OffGrid-Devices/Falange/README.md

# OffGrid-Devices Falange
Arduino-based delay weirdo

[BOM](https://docs.google.com/spreadsheets/d/1_OFgzQ-Cf3UgnrHv29c7YLzdb8jIv9dC1f2YYJAlo-E/edit?usp=sharing)
