OffGrid-Devices/Falange/schematics/Falange-NANO/PDF/FalangeNANO_Board_BOTTOM (mirrored).pdf

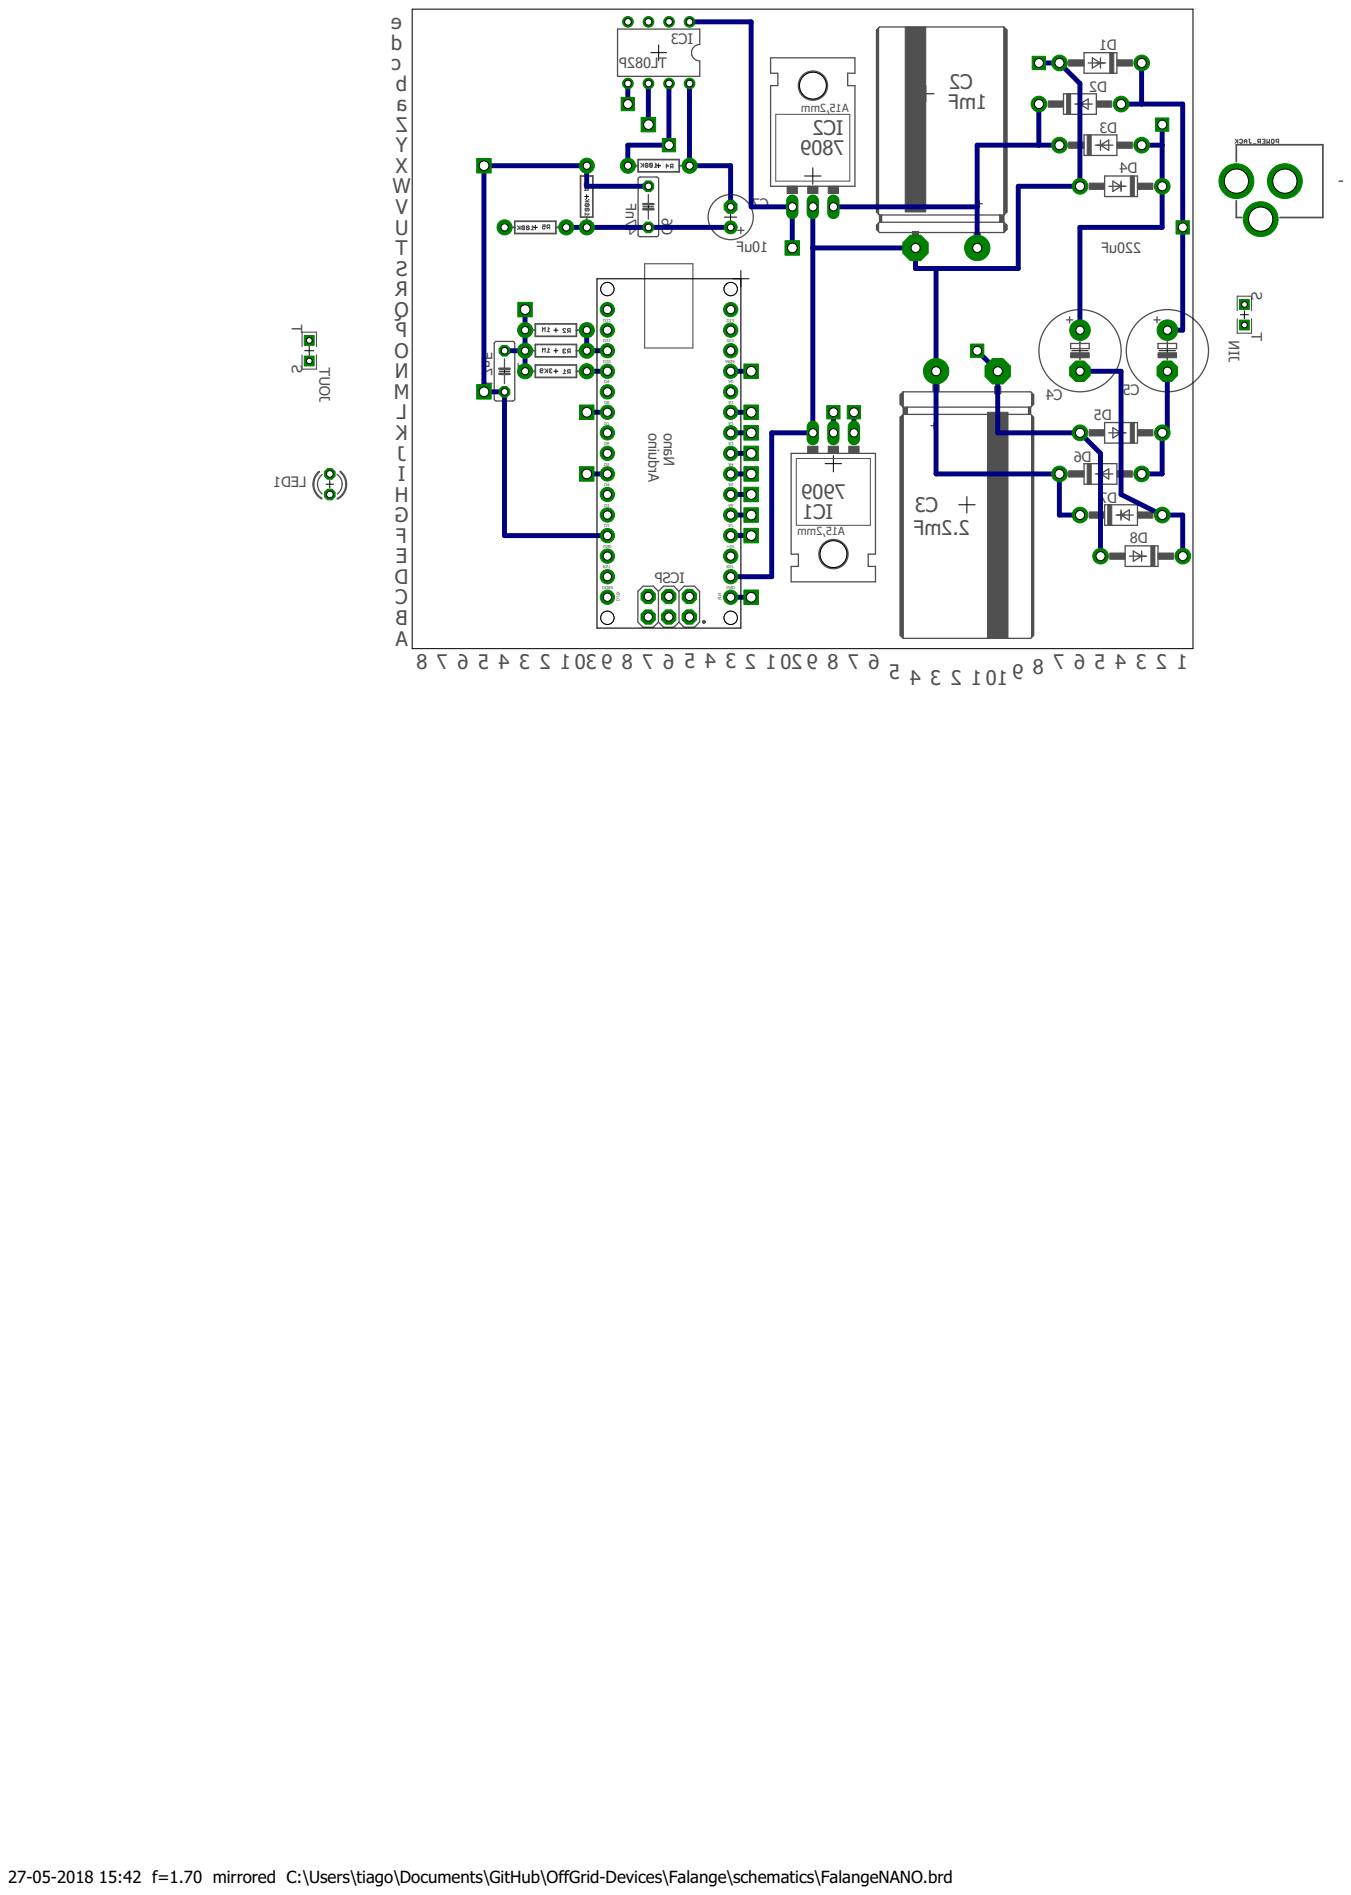
[picture p1: page 1]

27-05-2018 15:42 f=1.70 mirrored C:\Users\tiago\Documents\GitHub\OffGrid-Devices\Falange\schematics\FalangeNANO.brd

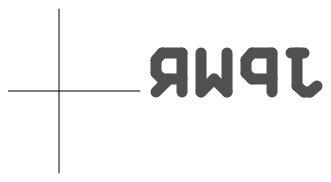
[picture p2: page 2]
