OffGrid-Devices/Falange/schematics/Falange-NANO/PDF/FalangeNANO_Components_TOP.pdf

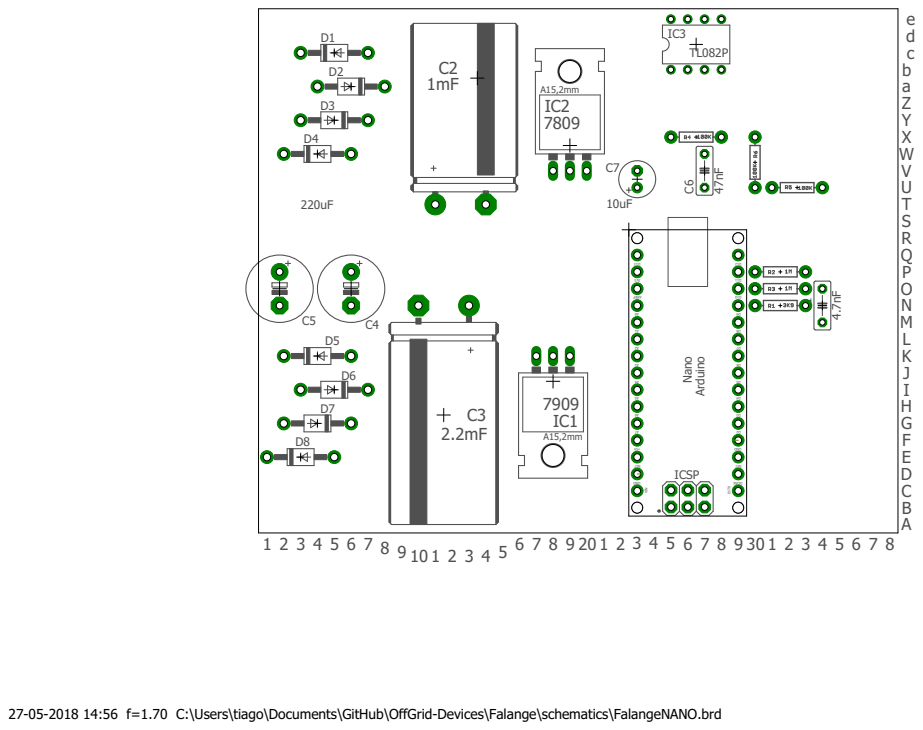
[picture p3: page 1]

27-05-2018 14:56 f=1.70 C:\Users\tiago\Documents\GitHub\OffGrid-Devices\Falange\schematics\FalangeNANO.brd
