OffGrid-Devices/Falange/schematics/Falange-NANO/PDF/FalangeNANO_OnBoard_Connections_5V_TOP.pdf

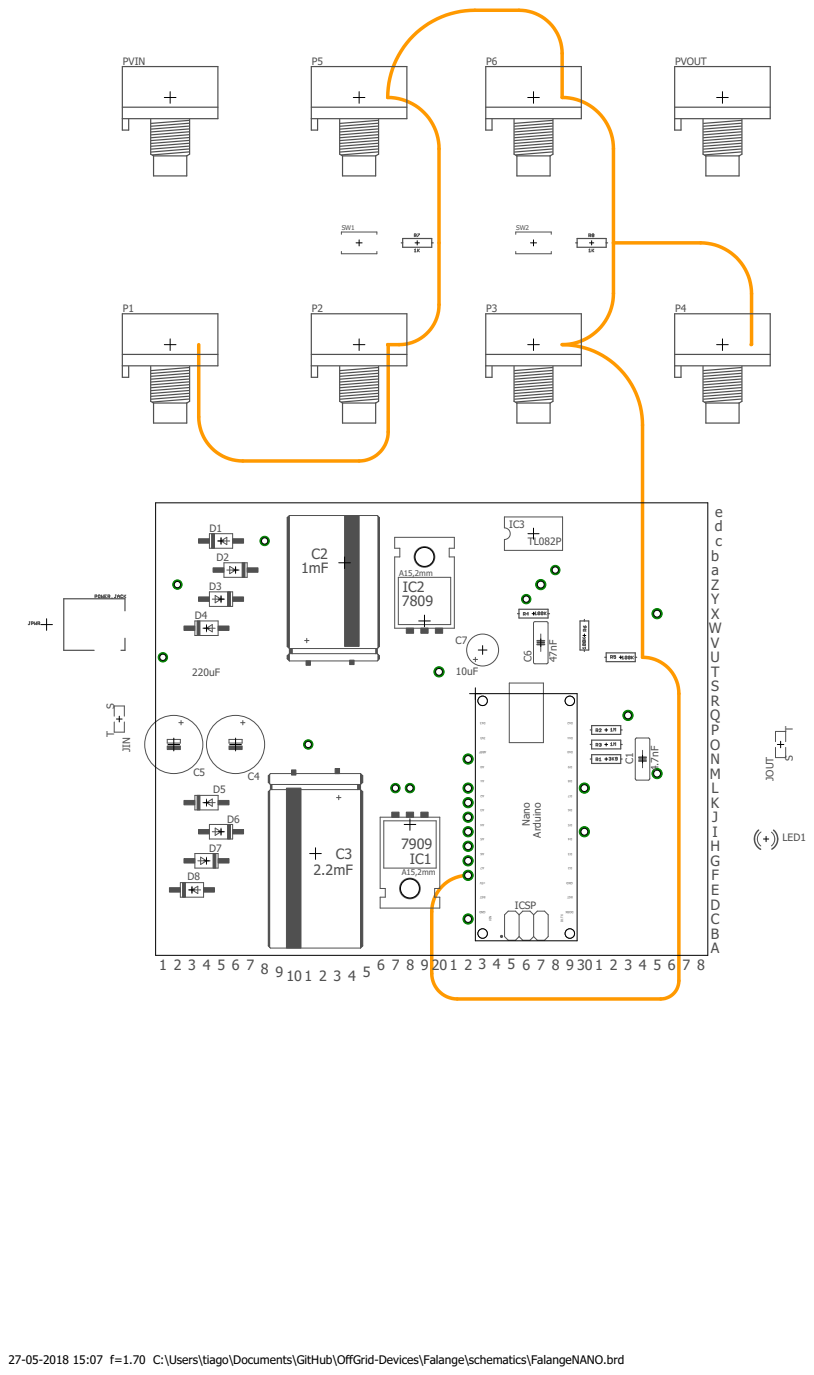
[picture p4: page 1]

27-05-2018 15:07 f=1.70 C:\Users\tiago\Documents\GitHub\OffGrid-Devices\Falange\schematics\FalangeNANO.brd
