OffGrid-Devices/Falange/schematics/Falange-NANO/PDF/FalangeNANO_OnBoard_Connections_9V_TOP.pdf

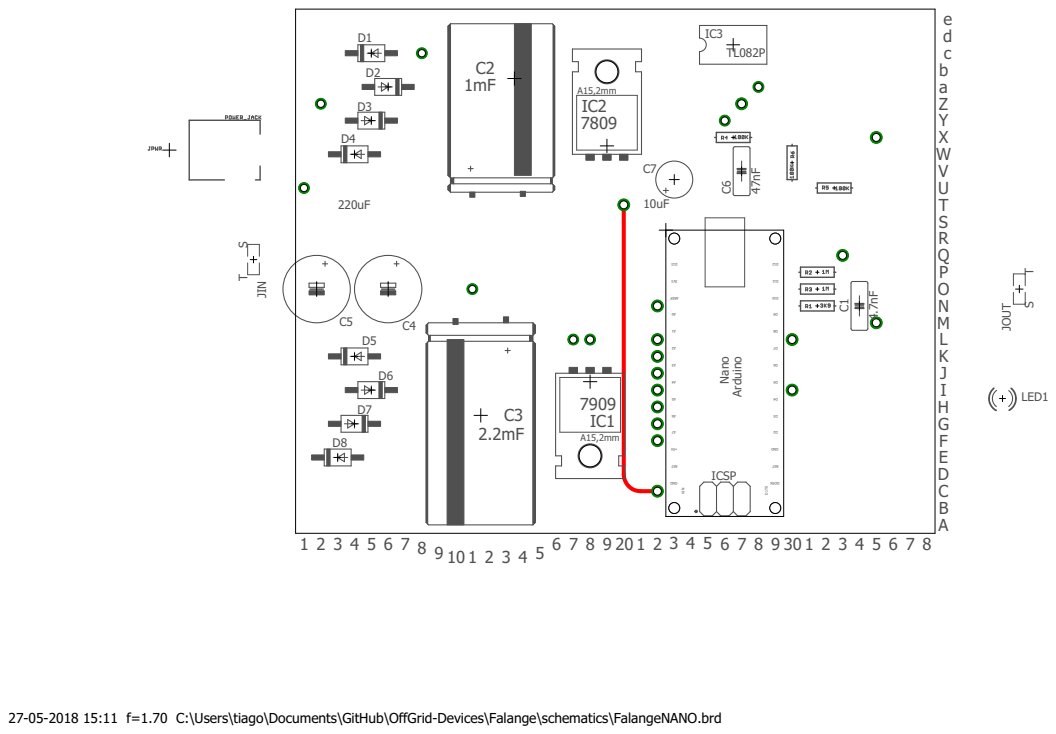
[picture p5: page 1]

27-05-2018 15:11 f=1.70 C:\Users\tiago\Documents\GitHub\OffGrid-Devices\Falange\schematics\FalangeNANO.brd
