OffGrid-Devices/Falange/schematics/Falange-NANO/PDF/FalangeNANO_OnBoard_Connections_GROUND_TOP.pdf

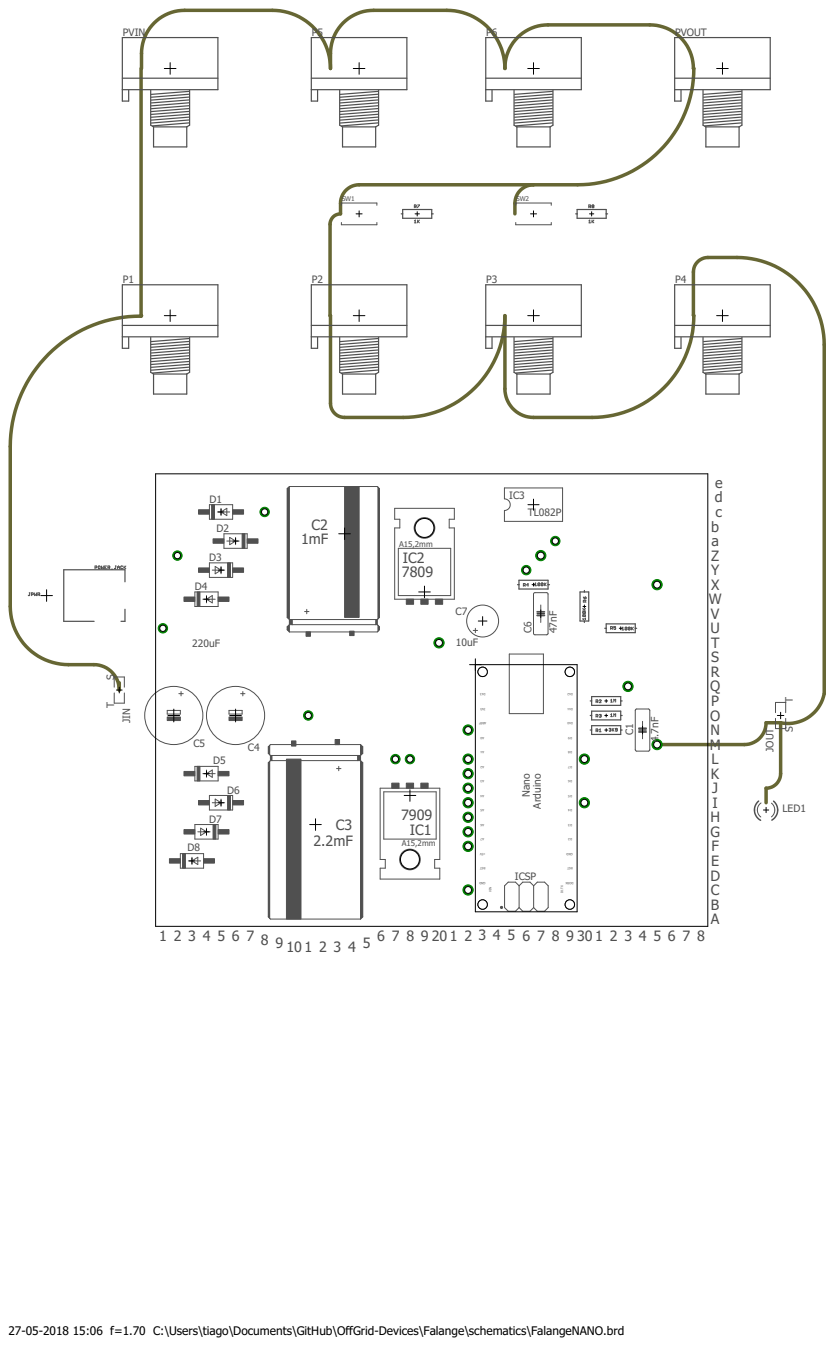
[picture p8: page 1]

27-05-2018 15:06 f=1.70 C:\Users\tiago\Documents\GitHub\OffGrid-Devices\Falange\schematics\FalangeNANO.brd
