OffGrid-Devices/Falange/schematics/FalangeNANO.brd

## EAGLE design schematics/FalangeNANO.brd (2019-09-03)

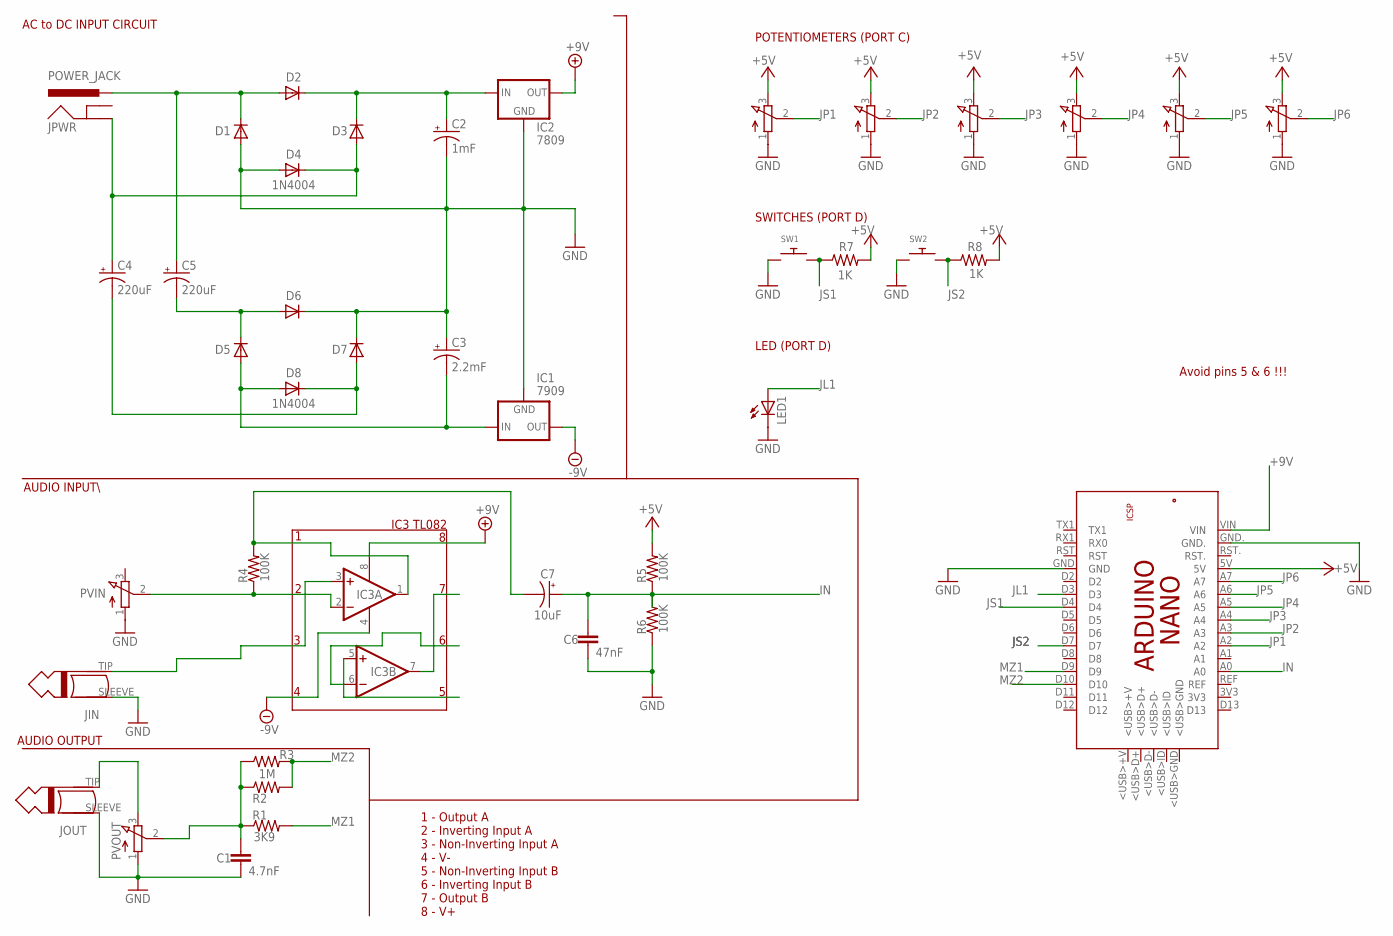
[picture p10: schematic FalangeNANO.sch]

Parts:
C1: 4.7nF; C050-025X075
C2: 1mF; E30-16
C3: 2.2mF; E35-16
C4, C5: 220uF; E5-10,5
C6: 47nF; C050-025X075
C7: 10uF; E2,5-6
D1, D2, D3, D4, D5, D6, D7, D8: 1N4004; DO41-10
IC1: 7909; 79XXL
IC2: 7809; 78XXL
IC3: TL082P; DIL08
JIN: MONO_PLUG; TWO_PADS
JOUT: MONO_PLUG; TWO_PADS
JPWR: POWER_JACK; POWER_JACK_PTH
LED1: LED3MM
P1, P2, P3, P4, P5, P6: 3RP/1610N
PCB1: ARDUINO_NANO
PVIN: 3RP/1610N
PVOUT: 3RP/1610N
R1: 3K9; AXIAL-0.3
R2, R3: 1M; AXIAL-0.3
R4, R5, R6: 100K; AXIAL-0.3
R7, R8: 1K; AXIAL-0.3
SW1, SW2: SWITCH_PUSHBUTTONEVQ-PE; TACT_PANA-EVQ

Connections:
+5V: P1.3 (E), P2.3 (E), P3.3 (E), P4.3 (E), P5.3 (E), P6.3 (E), PCB1.5V, R5.P$2 (2), R7.P$2 (2), R8.P$2 (2)
+9V: IC2.OUT, IC3.8 (V+), PCB1.VIN
-9V: IC1.OUT, IC3.4 (V-)
GND: C1.2, C2.-, C3.+, C6.2, D1.A, D4.A, D6.C, D7.C, IC1.GND, IC2.GND, JIN.SLEEVE, JOUT.SLEEVE, LED1.K (C), P1.1 (A), P2.1 (A), P3.1 (A), P4.1 (A), P5.1 (A), P6.1 (A), PCB1.GND, PCB1.GND., PVIN.1 (A), PVOUT.1 (A), R6.P$1 (1), SW1.P$1, SW2.P$1
IN: C6.1, C7.+, PCB1.A0, R5.P$1 (1), R6.P$2 (2)
JL1: LED1.A, PCB1.D3
JP1: P1.2 (S), PCB1.A2
JP2: P2.2 (S), PCB1.A3
JP3: P3.2 (S), PCB1.A4
JP4: P4.2 (S), PCB1.A5
JP5: P5.2 (S), PCB1.A6
JP6: P6.2 (S), PCB1.A7
JP8-2: C1.1, PVOUT.2 (S), R1.P$1 (1), R2.P$1 (1), R3.P$1 (1)
JP8-3: JOUT.TIP, PVOUT.3 (E)
JS1: PCB1.D4, R7.P$1 (1), SW1.P$2
JS2: PCB1.D7, R8.P$1 (1), SW2.P$2
MZ1: PCB1.D9, R1.P$2 (2)
MZ2: PCB1.D10, R2.P$2 (2), R3.P$2 (2)
unnamed: C5.-, D5.C, D6.A
unnamed: C4.-, D7.A, D8.C
unnamed: C2.+, D2.C, D3.C, IC2.IN
unnamed: C3.-, D5.A, D8.A, IC1.IN
unnamed: C7.-, IC3.1 (OUT), R4.P$2 (2)
unnamed: IC3.2 (-IN), PVIN.2 (S), R4.P$1 (1)
unnamed: IC3.3 (+IN), JIN.TIP
PWRSLV: C4.+, D3.A, D4.C, JPWR.GND
PWRTIP: C5.+, D1.C, D2.A, JPWR.PWR

Notes on the sheet:
AUDIO OUTPUT
AC to DC INPUT CIRCUIT
AUDIO INPUT\
IC3 TL082
1 - Output A 2 - Inverting Input A 3 - Non-Inverting Input A 4 - V- 5 - Non-Inverting Input B 6 - Inverting Input B 7 - Output B 8 - V+
POTENTIOMETERS (PORT C)
SWITCHES (PORT D)
LED (PORT D)
Avoid pins 5 & 6 !!!

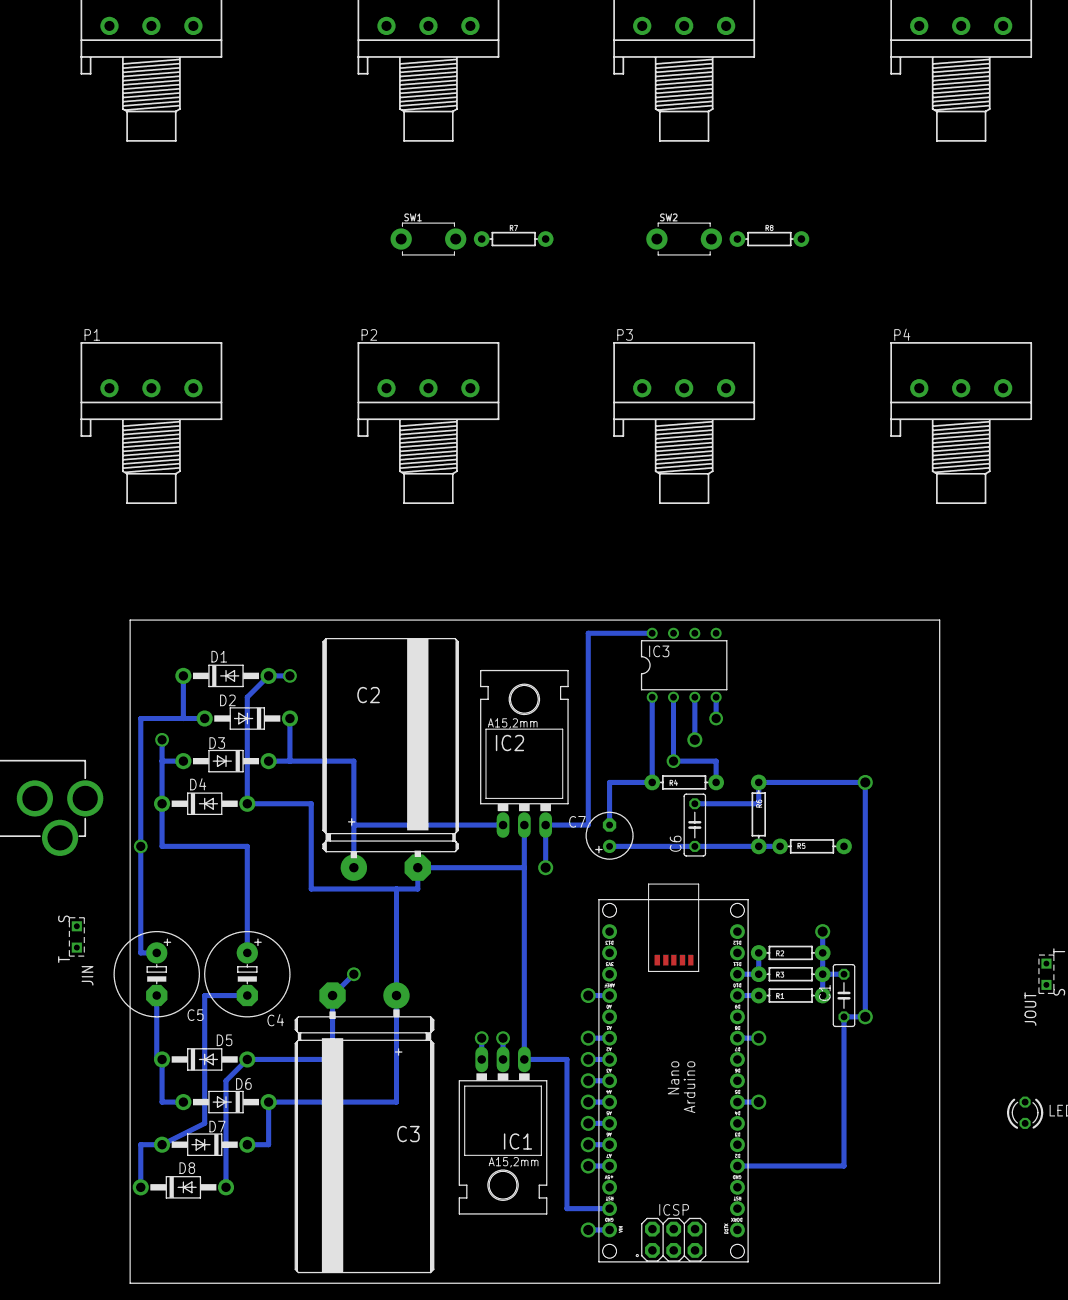
[picture p11: board FalangeNANO.brd from above]

Board: 16 copper layers, 96.5 x 79.0 mm, 41 parts (0 on the bottom side), 27 nets.
