OffGrid-Devices/Falange/(commit log)

2018-05-23 uploaded Falange Lite
    The only difference from "Falange" is that it doesn't have support for a
    piezo direct connection bypassing the pre-amplifier
    [Falange_Lite.brd, Falange_Lite.sch]
2018-05-23 uploaded Falange schematics
    [Falange.brd, Falange.sch]
2018-05-27 update falange schematics
    [Falange.brd, Falange.sch]
2018-05-27 basic prototype
2019-09-03 version 0.1
    [FalangeNANO.brd, FalangeNANO.sch]
2019-09-04 moving to version 0.2
    simple noise and selectable LP/HP filter
    [GLOBALS.h]
2019-09-04 simple filter implementation (LP/HP)
2019-09-04 kinda functional
    switch1 sets the filter pre or post delay
2019-09-04 implemented led blinking sync'd to LFO
2019-09-04 improved led function
2019-09-05 tuned both LP & HP filters to their best sounding parameters
2019-09-05 switch1 is now free
    the feedback delay certainly sounds better in the beginning of the chain
2019-09-05 updated hardware test to encompass circuit changes
    circuit changes: pin A7 has went bananas...moved to pin A1
2019-09-05 modulations#1
    - implemented LFO>DelaySize modulatino on switch1
    - implemented constrained feedback levels on modulation knob
